Ozonised/Udayate/README.md

# Udayate
An open source flight controller based on STM32F411 microcontroller.
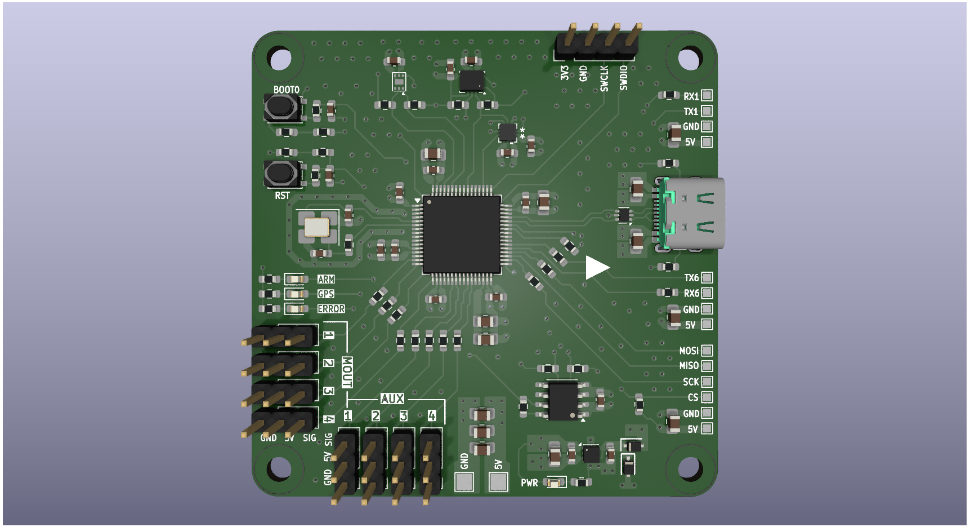
[picture p1: FrontRev2.png]
Front

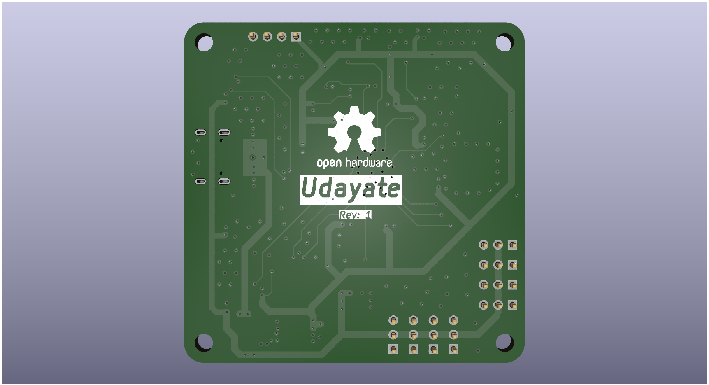
[picture p2: BackRev2.png]
Back
