Ozonised/Udayate/Udayate.kicad_pcb

## KiCad design Udayate.kicad_pcb (2026-01-23)

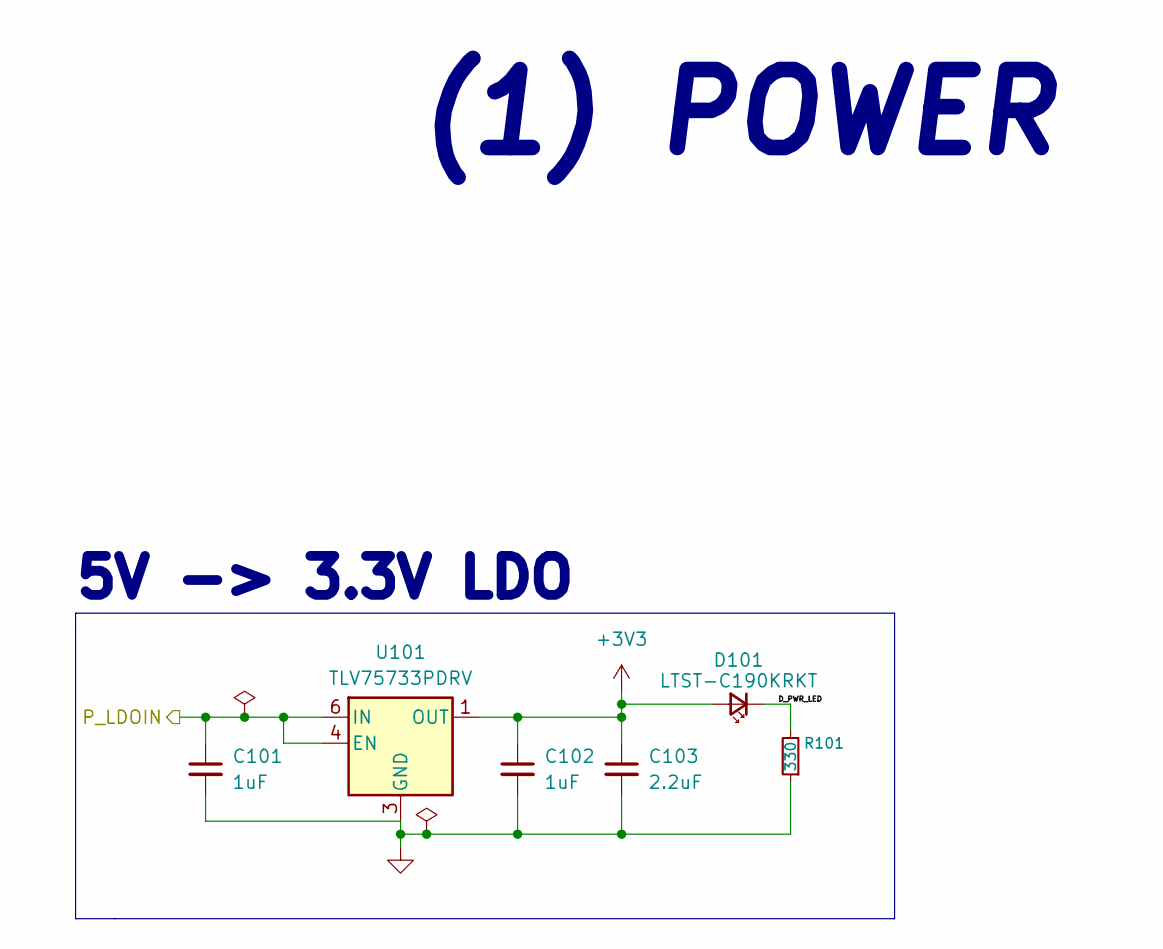
[picture p3: schematic Power.kicad_sch, Udayate]

Parts:
C101, C102: 1uF; C_0603_1608Metric_Pad1.08x0.95mm_HandSolder; MPN C1608X7R1V105K080AC
C103: 2.2uF; C_0805_2012Metric_Pad1.18x1.45mm_HandSolder; MPN GCM21BR71C225MA64L
D101: LTST-C190KRKT; LED_0603_1608Metric_Pad1.05x0.95mm_HandSolder; MPN LTST-C190KRKT
R101: 330; R_0603_1608Metric_Pad0.98x0.95mm_HandSolder; MPN CR0603-FX-3300ELF
U101: TLV75733PDRV; WSON-6-1EP_2x2mm_P0.65mm_EP1x1.6mm; MPN TLV75733PDRV

Connections:
+3V3: C102.1, C103.1, D101.2 (A), U101.1 (OUT); also elsewhere on the board
/IO/P_LDOIN: C101.1, U101.4 (EN), U101.6 (IN); also elsewhere on the board
/Power/D_PWR_LED: D101.1 (K), R101.2
GND: C101.2, C102.2, C103.2, R101.1, U101.3 (GND), U101.7 (GND); also elsewhere on the board

Notes on the sheet:
(1) POWER
5V -> 3.3V LDO

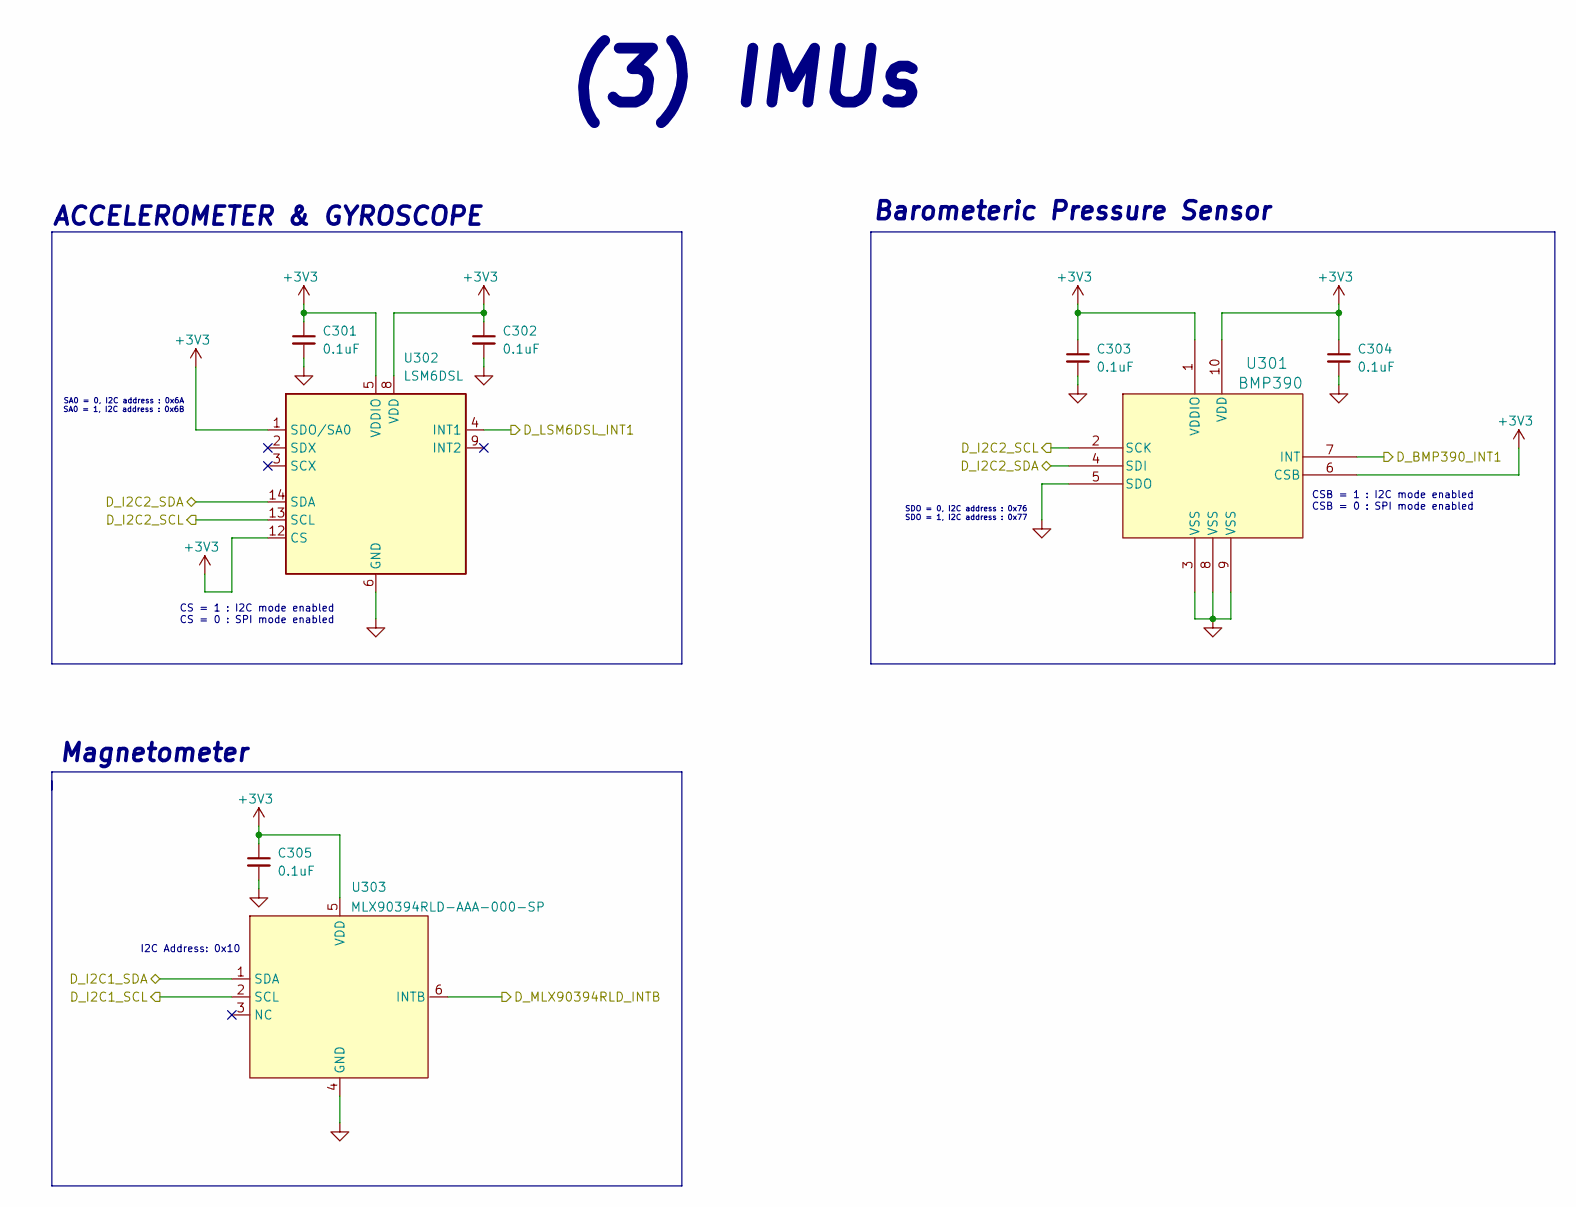
[picture p4: schematic IMUs.kicad_sch, Udayate]

Parts:
C301, C302, C303, C304, C305: 0.1uF; C_0603_1608Metric_Pad1.08x0.95mm_HandSolder; MPN C1608X5R1H104K080AA
U301: BMP390; 10LGA_2X2X0p75_BOS; MPN BMP390
U302: LSM6DSL; LGA-14_3x2.5mm_P0.5mm_LayoutBorder3x4y; MPN LSM6DSL
U303: MLX90394RLD-AAA-000-SP; MLX90394RLD; MPN MLX90394RLD-AAA-000-SP

Connections:
+3V3: C301.1, C302.1, C303.1, C304.1, C305.1, U301.1 (VDDIO), U301.6 (CSB), U301.10 (VDD), U302.1 (SDO/SA0), U302.5 (VDDIO), U302.8 (VDD), U302.12 (CS), U303.5 (VDD); also elsewhere on the board
/IMUs/D_BMP390_INT1: U301.7 (INT); also elsewhere on the board
/IMUs/D_I2C1_SCL: U303.2 (SCL); also elsewhere on the board
/IMUs/D_I2C1_SDA: U303.1 (SDA); also elsewhere on the board
/IMUs/D_I2C2_SCL: U301.2 (SCK), U302.13 (SCL); also elsewhere on the board
/IMUs/D_I2C2_SDA: U301.4 (SDI), U302.14 (SDA); also elsewhere on the board
/IMUs/D_LSM6DSL_INT1: U302.4 (INT1); also elsewhere on the board
/IMUs/D_MLX90394RLD_INTB: U303.6 (INTB); also elsewhere on the board
GND: C301.2, C302.2, C303.2, C304.2, C305.2, U301.3 (VSS), U301.5 (SDO), U301.8 (VSS), U301.9 (VSS), U302.6 (GND), U302.7 (GND), U303.4 (GND); also elsewhere on the board

Notes on the sheet:
CSB = 1 : I2C mode enabled CSB = 0 : SPI mode enabled
(3) IMUs
Magnetometer
SDO = 0, I2C address : 0x76 SDO = 1, I2C address : 0x77
SA0 = 0, I2C address : 0x6A SA0 = 1, I2C address : 0x6B
CS = 1 : I2C mode enabled CS = 0 : SPI mode enabled
I2C Address: 0x10
Barometeric Pressure Sensor
ACCELEROMETER & GYROSCOPE

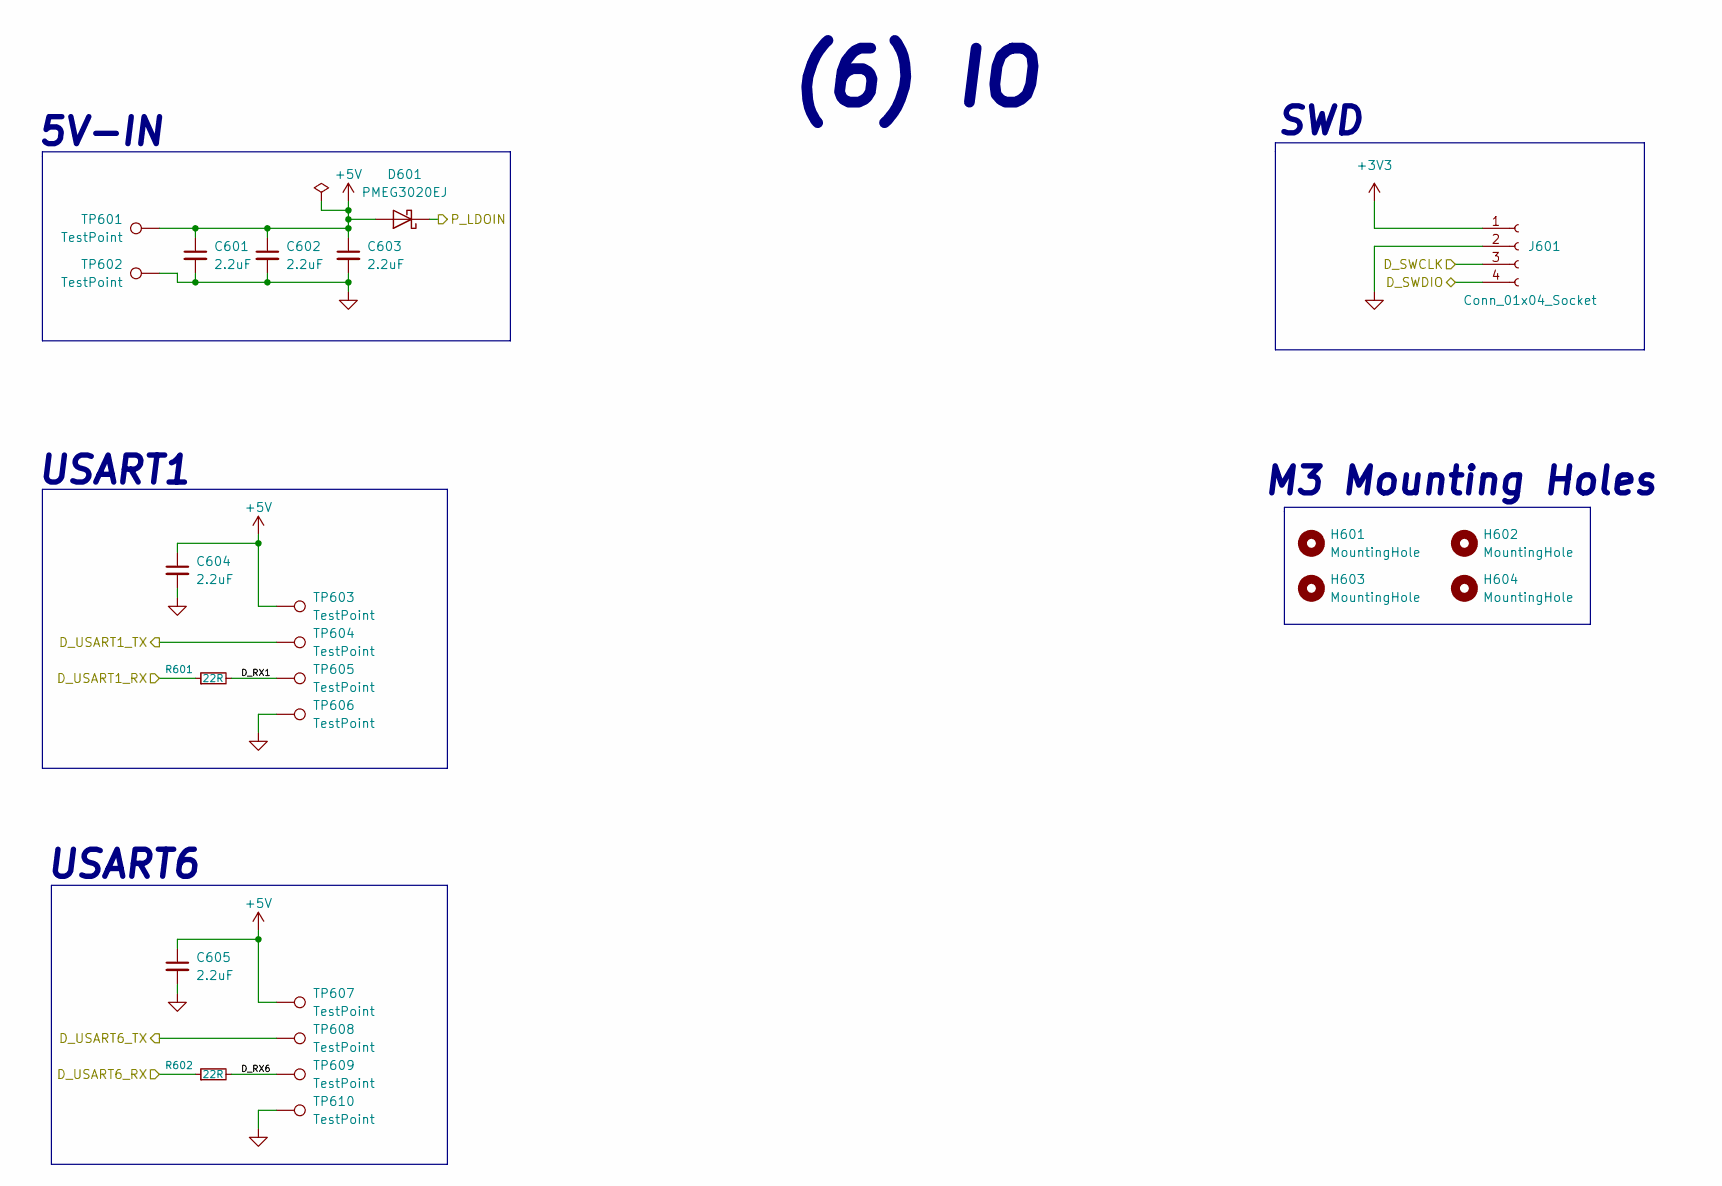
[picture p5: schematic IO2.kicad_sch, Udayate]

Parts:
C601, C602, C603, C604, C605: 2.2uF; C_0805_2012Metric_Pad1.18x1.45mm_HandSolder; MPN GCM21BR71C225MA64L
D601: PMEG3020EJ; D_SOD-323F; MPN PMEG3020EJ,115
H601, H602, H603, H604: MountingHole; MountingHole_3.2mm_M3
J601: Conn_01x04_Socket; PinHeader_1x04_P2.54mm_Vertical
R601, R602: 22R; R_0603_1608Metric_Pad0.98x0.95mm_HandSolder; MPN CR0603-FX-22R0ELF
TP601, TP602: TestPoint; TestPoint_Pad_2.0x2.0mm
TP603, TP604, TP605, TP606, TP607, TP608, TP609, TP610: TestPoint; TestPoint_Pad_1.0x1.0mm

Connections:
+3V3: J601.1; also elsewhere on the board
+5V: C601.1, C602.1, C603.1, C604.1, C605.1, D601.2 (A), TP601.1, TP603.1, TP607.1; also elsewhere on the board
/IO2/D_RX1: R601.2, TP605.1
/IO2/D_RX6: R602.2, TP609.1
/IO2/D_SWCLK: J601.3; also elsewhere on the board
/IO2/D_SWDIO: J601.4; also elsewhere on the board
/IO2/D_USART1_RX: R601.1; also elsewhere on the board
/IO2/D_USART1_TX: TP604.1; also elsewhere on the board
/IO2/D_USART6_RX: R602.1; also elsewhere on the board
/IO2/D_USART6_TX: TP608.1; also elsewhere on the board
/IO/P_LDOIN: D601.1 (K); also elsewhere on the board
GND: C601.2, C602.2, C603.2, C604.2, C605.2, J601.2, TP602.1, TP606.1, TP610.1; also elsewhere on the board

Notes on the sheet:
5V-IN
USART1
(6) IO
SWD
USART6
M3 Mounting Holes

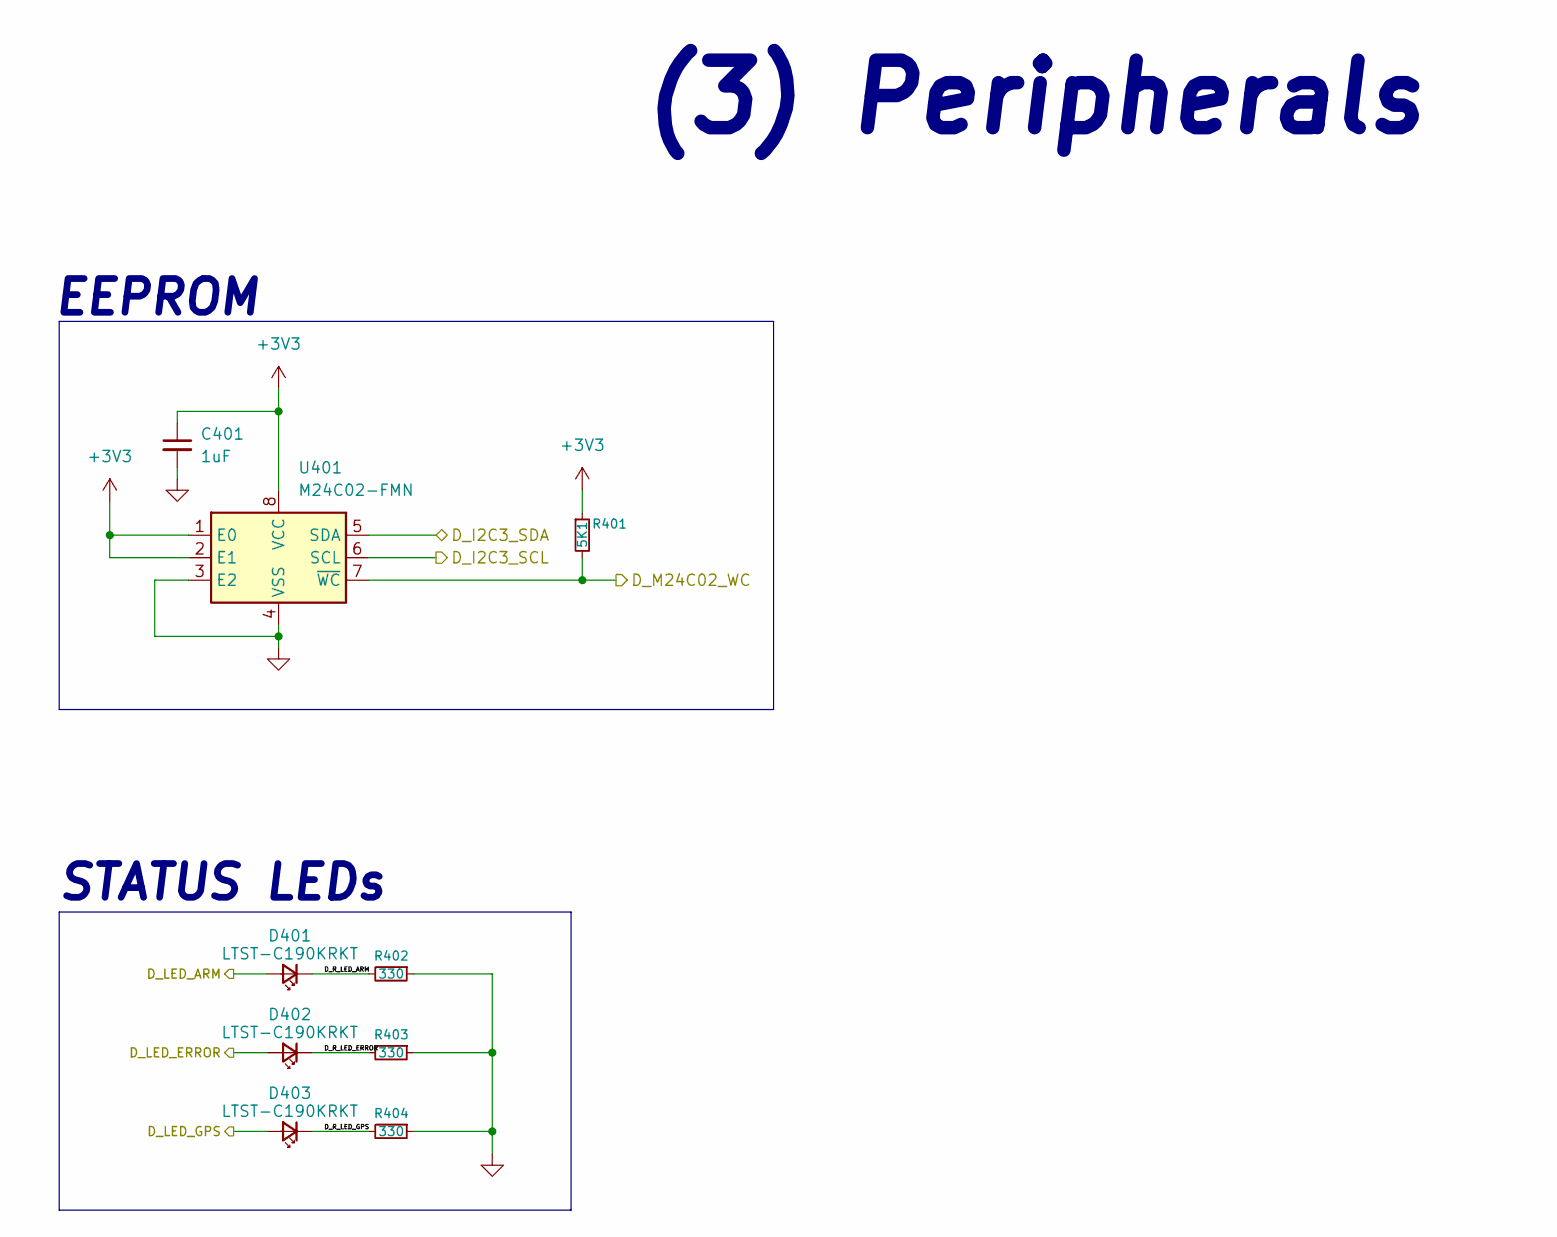
[picture p6: schematic Peripherals.kicad_sch, Udayate]

Parts:
C401: 1uF; C_0603_1608Metric_Pad1.08x0.95mm_HandSolder; MPN C1608X7R1V105K080AC
D401, D402, D403: LTST-C190KRKT; LED_0603_1608Metric_Pad1.05x0.95mm_HandSolder; MPN LTST-C190KRKT
R401: 5K1; R_0603_1608Metric_Pad0.98x0.95mm_HandSolder; MPN CR0603-FX-5101ELF
R402, R403, R404: 330; R_0603_1608Metric_Pad0.98x0.95mm_HandSolder; MPN CR0603-FX-3300ELF
U401: M24C02-FMN; SOIC-8_3.9x4.9mm_P1.27mm; MPN M24C02-FMN6TP

Connections:
+3V3: C401.1, R401.1, U401.1 (E0), U401.2 (E1), U401.8 (VCC); also elsewhere on the board
/MCU/D_I2C3_SCL: U401.6 (SCL); also elsewhere on the board
/MCU/D_I2C3_SDA: U401.5 (SDA); also elsewhere on the board
/MCU/D_LED_ARM: D401.2 (A); also elsewhere on the board
/MCU/D_LED_ERROR: D402.2 (A); also elsewhere on the board
/MCU/D_LED_GPS: D403.2 (A); also elsewhere on the board
/MCU/D_M24C02_WC: R401.2, U401.7 (~WC); also elsewhere on the board
/Peripherals/D_R_LED_ARM: D401.1 (K), R402.2
/Peripherals/D_R_LED_ERROR: D402.1 (K), R403.2
/Peripherals/D_R_LED_GPS: D403.1 (K), R404.2
GND: C401.2, R402.1, R403.1, R404.1, U401.3 (E2), U401.4 (VSS); also elsewhere on the board

Notes on the sheet:
(3) Peripherals
STATUS LEDs
EEPROM

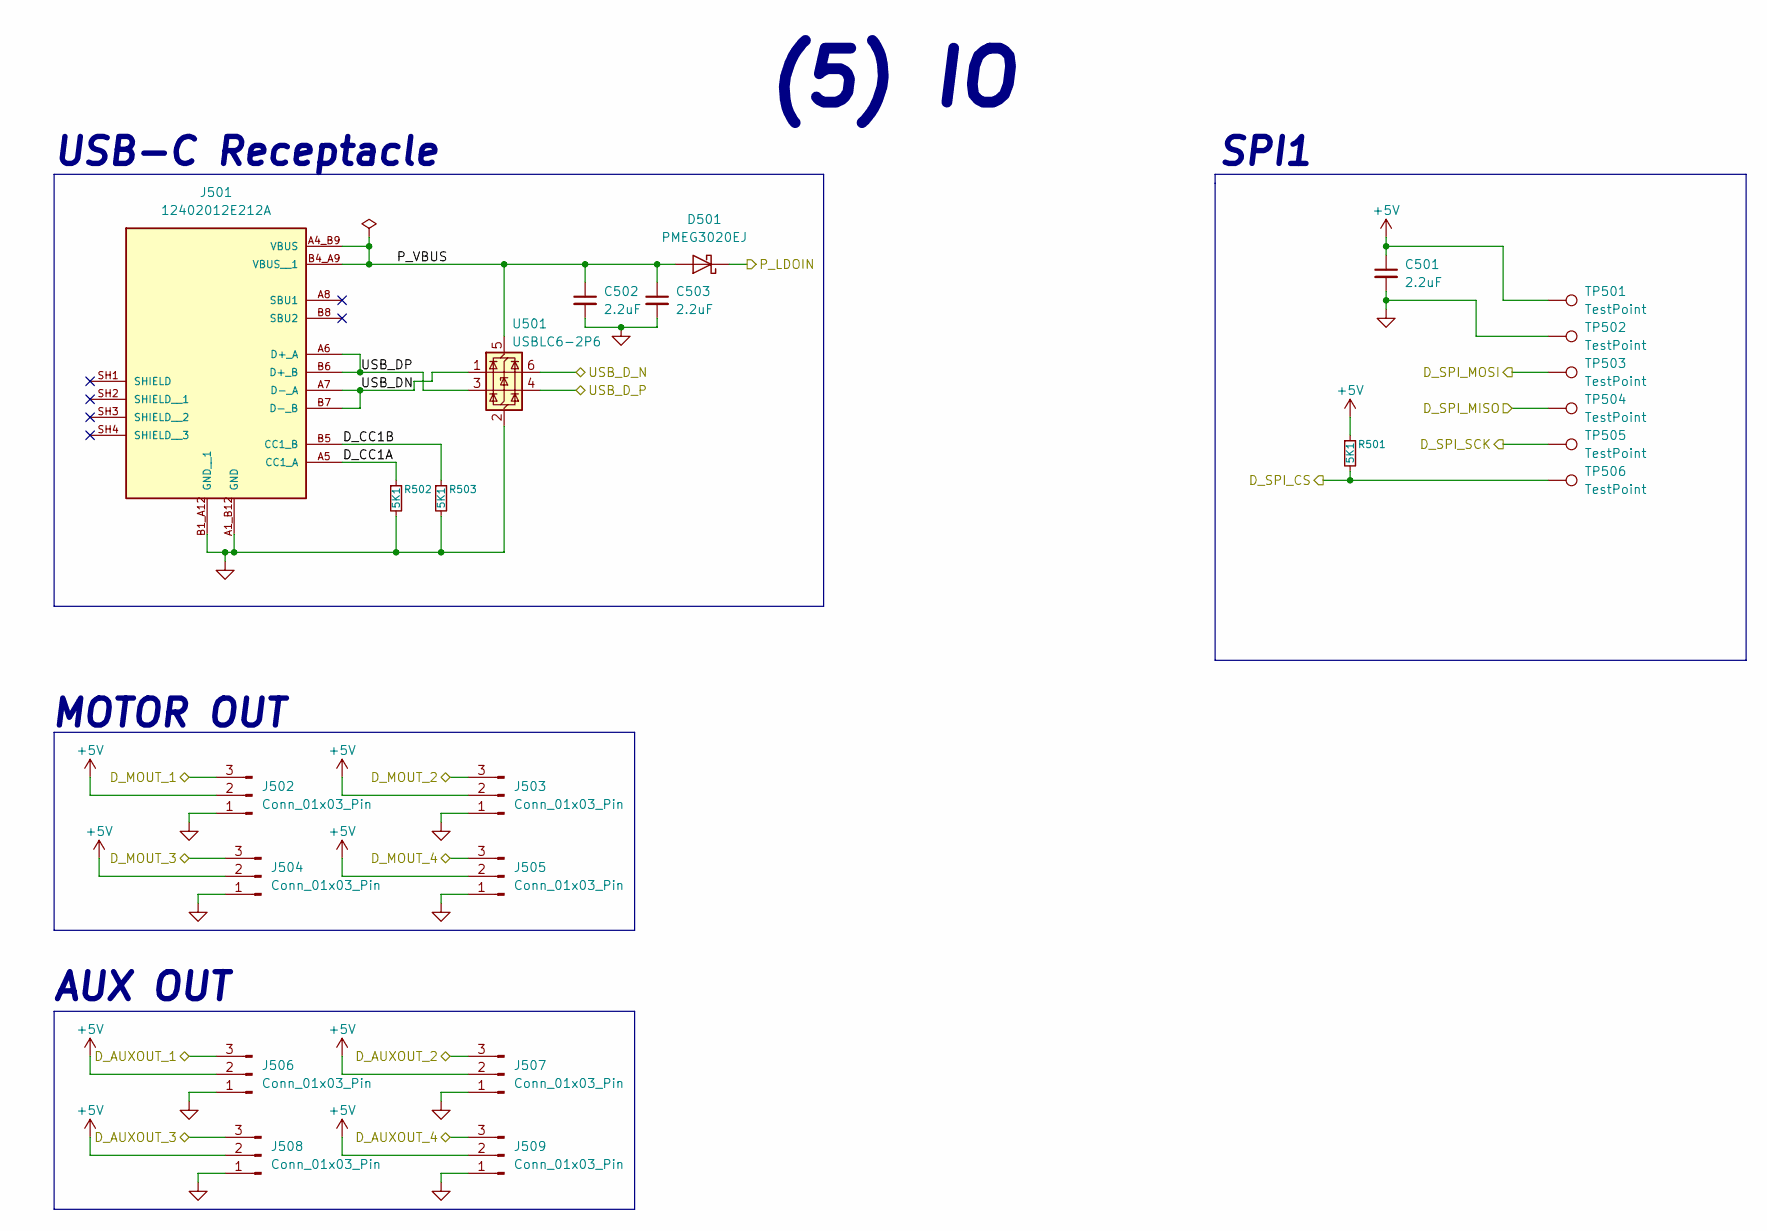
[picture p7: schematic IO.kicad_sch, Udayate]

Parts:
C501, C502, C503: 2.2uF; C_0805_2012Metric_Pad1.18x1.45mm_HandSolder; MPN GCM21BR71C225MA64L
D501: PMEG3020EJ; D_SOD-323F; MPN PMEG3020EJ,115
J501: 12402012E212A; AMPHENOL_12402012E212A; PARTREV 4
J502, J503, J504, J505, J506, J507, J508, J509: Conn_01x03_Pin; PinHeader_1x03_P2.54mm_Vertical
R501, R502, R503: 5K1; R_0603_1608Metric_Pad0.98x0.95mm_HandSolder; MPN CR0603-FX-5101ELF
TP501, TP502, TP503, TP504, TP505, TP506: TestPoint; TestPoint_Pad_1.0x1.0mm
U501: USBLC6-2P6; SOT-666

Connections:
+5V: C501.1, J502.2, J503.2, J504.2, J505.2, J506.2, J507.2, J508.2, J509.2, R501.1, TP501.1; also elsewhere on the board
/IO/D_AUXOUT_1: J506.3; also elsewhere on the board
/IO/D_AUXOUT_2: J507.3; also elsewhere on the board
/IO/D_AUXOUT_3: J508.3; also elsewhere on the board
/IO/D_AUXOUT_4: J509.3; also elsewhere on the board
/IO/D_CC1A: J501.A5 (CC1_A), R502.1
/IO/D_CC1B: J501.B5 (CC1_B), R503.1
/IO/D_MOUT_1: J502.3; also elsewhere on the board
/IO/D_MOUT_2: J503.3; also elsewhere on the board
/IO/D_MOUT_3: J504.3; also elsewhere on the board
/IO/D_MOUT_4: J505.3; also elsewhere on the board
/IO/D_SPI_CS: R501.2, TP506.1; also elsewhere on the board
/IO/D_SPI_MISO: TP504.1; also elsewhere on the board
/IO/D_SPI_MOSI: TP503.1; also elsewhere on the board
/IO/D_SPI_SCK: TP505.1; also elsewhere on the board
/IO/P_LDOIN: D501.1 (K); also elsewhere on the board
/IO/P_VBUS: C502.1, C503.1, D501.2 (A), J501.A4_B9 (VBUS), J501.B4_A9 (VBUS__1), U501.5 (VBUS)
/IO/USB_DN: J501.A7 (D-_A), J501.B7 (D-_B), U501.1 (I/O1)
/IO/USB_DP: J501.A6 (D+_A), J501.B6 (D+_B), U501.3 (I/O2)
/IO/USB_D_N: U501.6 (I/O1); also elsewhere on the board
/IO/USB_D_P: U501.4 (I/O2); also elsewhere on the board
GND: C501.2, C502.2, C503.2, J501.A1_B12 (GND), J501.B1_A12 (GND__1), J502.1, J503.1, J504.1, J505.1, J506.1, J507.1, J508.1, J509.1, R502.2, R503.2, TP502.1, U501.2 (GND); also elsewhere on the board

Notes on the sheet:
MOTOR OUT
SPI1
USB-C Receptacle
(5) IO
AUX OUT

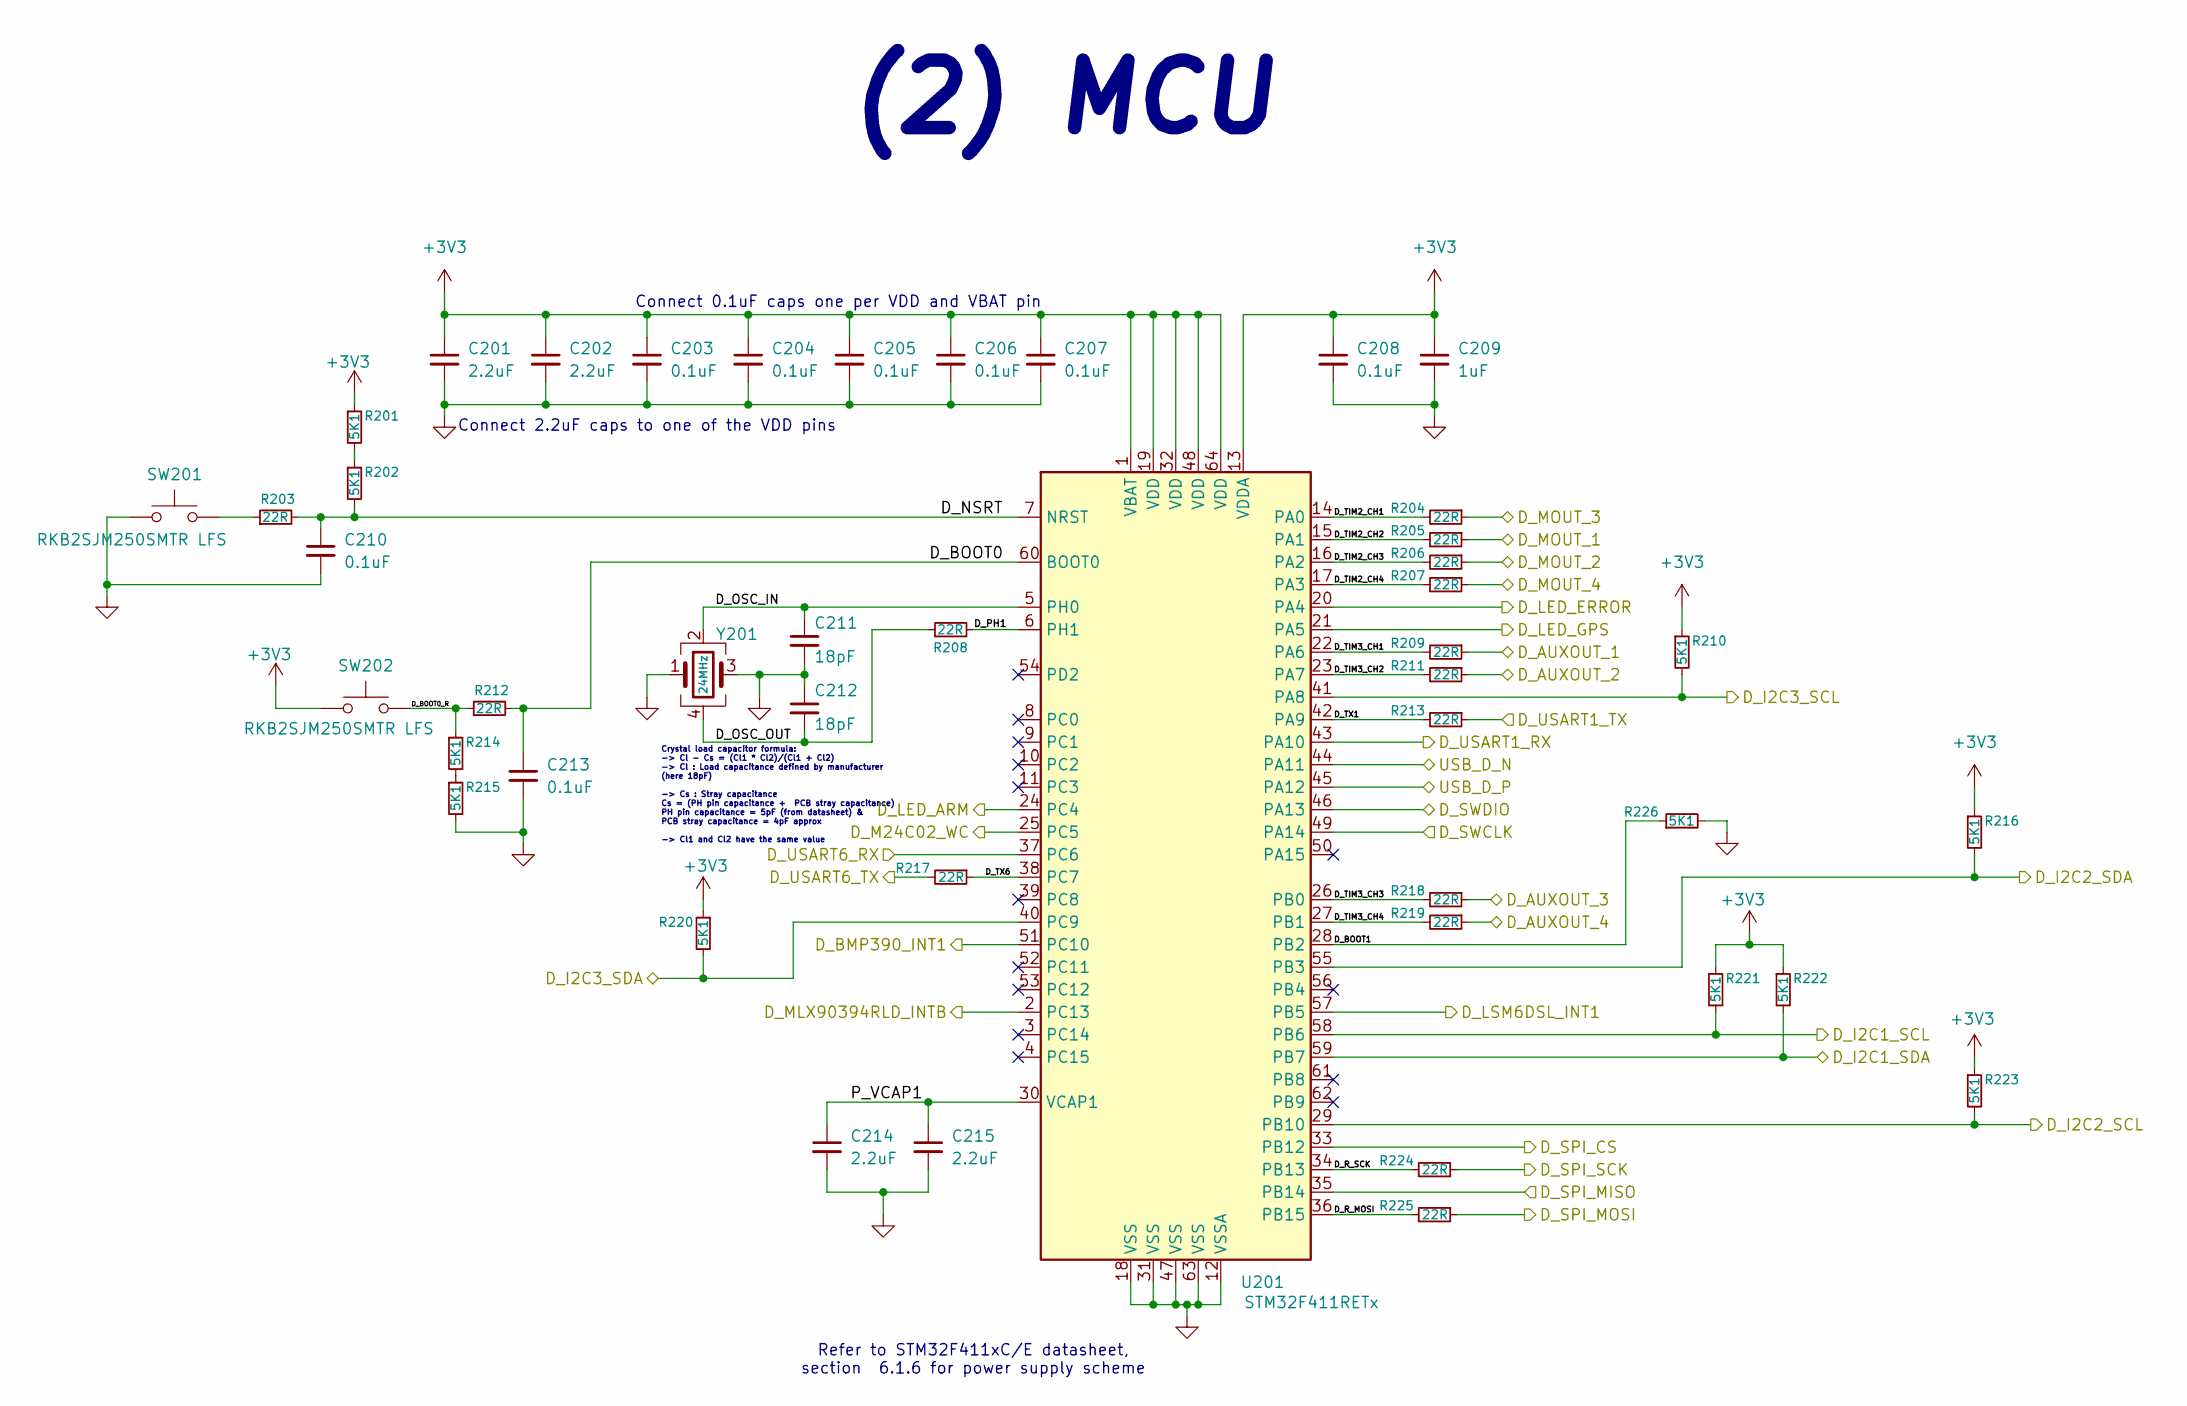
[picture p8: schematic MCU.kicad_sch, Udayate]

Parts:
C201, C202, C214, C215: 2.2uF; C_0805_2012Metric_Pad1.18x1.45mm_HandSolder; MPN GCM21BR71C225MA64L
C203, C204, C205, C206, C207, C208, C210, C213: 0.1uF; C_0603_1608Metric_Pad1.08x0.95mm_HandSolder; MPN C1608X5R1H104K080AA
C209: 1uF; C_0603_1608Metric_Pad1.08x0.95mm_HandSolder; MPN C1608X7R1V105K080AC
C211, C212: 18pF; C_0603_1608Metric_Pad1.08x0.95mm_HandSolder; MPN 06035A180JAT4A
R201, R202, R210, R214, R215, R216, R220, R221, R222, R223, R226: 5K1; R_0603_1608Metric_Pad0.98x0.95mm_HandSolder; MPN CR0603-FX-5101ELF
R203, R204, R205, R206, R207, R208, R209, R211, R212, R213, R217, R218, R219, R224, R225: 22R; R_0603_1608Metric_Pad0.98x0.95mm_HandSolder; MPN CR0603-FX-22R0ELF
SW201, SW202: RKB2SJM250SMTR LFS; SW_SPST_PTS810; MPN RKB2SJM250SMTR LFS
U201: STM32F411RETx; LQFP-64_10x10mm_P0.5mm; MPN STM32F411RET6
Y201: 24MHz; Crystal_SMD_3225-4Pin_3.2x2.5mm_HandSoldering; MPN ABM8-24.000MHZ-D4Y-T

Connections:
+3V3: C201.1, C202.1, C203.1, C204.1, C205.1, C206.1, C207.1, C208.1, C209.1, R201.1, R210.1, R216.1, R220.1, R221.1, R222.1, R223.1, SW202.1, U201.1 (VBAT), U201.13 (VDDA), U201.19 (VDD), U201.32 (VDD), U201.48 (VDD), U201.64 (VDD); also elsewhere on the board
/IMUs/D_BMP390_INT1: U201.51 (PC10); also elsewhere on the board
/IMUs/D_I2C1_SCL: R221.2, U201.58 (PB6); also elsewhere on the board
/IMUs/D_I2C1_SDA: R222.2, U201.59 (PB7); also elsewhere on the board
/IMUs/D_I2C2_SCL: R223.2, U201.29 (PB10); also elsewhere on the board
/IMUs/D_I2C2_SDA: R216.2, U201.55 (PB3); also elsewhere on the board
/IMUs/D_LSM6DSL_INT1: U201.57 (PB5); also elsewhere on the board
/IMUs/D_MLX90394RLD_INTB: U201.2 (PC13); also elsewhere on the board
/IO2/D_SWCLK: U201.49 (PA14); also elsewhere on the board
/IO2/D_SWDIO: U201.46 (PA13); also elsewhere on the board
/IO2/D_USART1_RX: U201.43 (PA10); also elsewhere on the board
/IO2/D_USART1_TX: R213.1; also elsewhere on the board
/IO2/D_USART6_RX: U201.37 (PC6); also elsewhere on the board
/IO2/D_USART6_TX: R217.2; also elsewhere on the board
/IO/D_AUXOUT_1: R209.1; also elsewhere on the board
/IO/D_AUXOUT_2: R211.1; also elsewhere on the board
/IO/D_AUXOUT_3: R218.1; also elsewhere on the board
/IO/D_AUXOUT_4: R219.1; also elsewhere on the board
/IO/D_MOUT_1: R205.1; also elsewhere on the board
/IO/D_MOUT_2: R206.1; also elsewhere on the board
/IO/D_MOUT_3: R204.1; also elsewhere on the board
/IO/D_MOUT_4: R207.1; also elsewhere on the board
/IO/D_SPI_CS: U201.33 (PB12); also elsewhere on the board
/IO/D_SPI_MISO: U201.35 (PB14); also elsewhere on the board
/IO/D_SPI_MOSI: R225.1; also elsewhere on the board
/IO/D_SPI_SCK: R224.1; also elsewhere on the board
/IO/USB_D_N: U201.44 (PA11); also elsewhere on the board
/IO/USB_D_P: U201.45 (PA12); also elsewhere on the board
/MCU/D_BOOT0: C213.1, R212.2, U201.60 (BOOT0)
/MCU/D_BOOT0_R: R212.1, R214.1, SW202.2
/MCU/D_BOOT1: R226.1, U201.28 (PB2)
/MCU/D_I2C3_SCL: R210.2, U201.41 (PA8); also elsewhere on the board
/MCU/D_I2C3_SDA: R220.2, U201.40 (PC9); also elsewhere on the board
/MCU/D_LED_ARM: U201.24 (PC4); also elsewhere on the board
/MCU/D_LED_ERROR: U201.20 (PA4); also elsewhere on the board
/MCU/D_LED_GPS: U201.21 (PA5); also elsewhere on the board
/MCU/D_M24C02_WC: U201.25 (PC5); also elsewhere on the board
/MCU/D_NSRT: C210.1, R202.2, R203.2, U201.7 (NRST)
/MCU/D_OSC_IN: C211.1, U201.5 (PH0), Y201.2
/MCU/D_OSC_OUT: C212.2, R208.1, Y201.4
/MCU/D_PH1: R208.2, U201.6 (PH1)
/MCU/D_R_MOSI: R225.2, U201.36 (PB15)
/MCU/D_R_SCK: R224.2, U201.34 (PB13)
/MCU/D_TIM2_CH1: R204.2, U201.14 (PA0)
/MCU/D_TIM2_CH2: R205.2, U201.15 (PA1)
/MCU/D_TIM2_CH3: R206.2, U201.16 (PA2)
/MCU/D_TIM2_CH4: R207.2, U201.17 (PA3)
/MCU/D_TIM3_CH1: R209.2, U201.22 (PA6)
/MCU/D_TIM3_CH2: R211.2, U201.23 (PA7)
/MCU/D_TIM3_CH3: R218.2, U201.26 (PB0)
/MCU/D_TIM3_CH4: R219.2, U201.27 (PB1)
/MCU/D_TX1: R213.2, U201.42 (PA9)
/MCU/D_TX6: R217.1, U201.38 (PC7)
/MCU/P_VCAP1: C214.1, C215.1, U201.30 (VCAP1)
GND: C201.2, C202.2, C203.2, C204.2, C205.2, C206.2, C207.2, C208.2, C209.2, C210.2, C211.2, C212.1, C213.2, C214.2, C215.2, R215.2, R226.2, SW201.1, U201.12 (VSSA), U201.18 (VSS), U201.31 (VSS), U201.47 (VSS), U201.63 (VSS), Y201.1, Y201.3; also elsewhere on the board
unnamed: R201.2, R202.1
unnamed: R203.1, SW201.2
unnamed: R214.2, R215.1

Notes on the sheet:
Connect 0.1uF caps one per VDD and VBAT pin
Refer to STM32F411xC/E datasheet, section 6.1.6 for power supply scheme
Connect 2.2uF caps to one of the VDD pins
(2) MCU
Crystal load capacitor formula: -> Cl - Cs = (Cl1 * Cl2)/(Cl1 + Cl2) -> Cl : Load capacitance defined by manufacturer (here 18pF) -> Cs : Stray capacitance Cs = (PH pin capacitance + PCB stray capacitance) PH pin capacitance = 5pF (from datasheet) & PCB stray capacitance = 4pF approx -> Cl1 and Cl2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

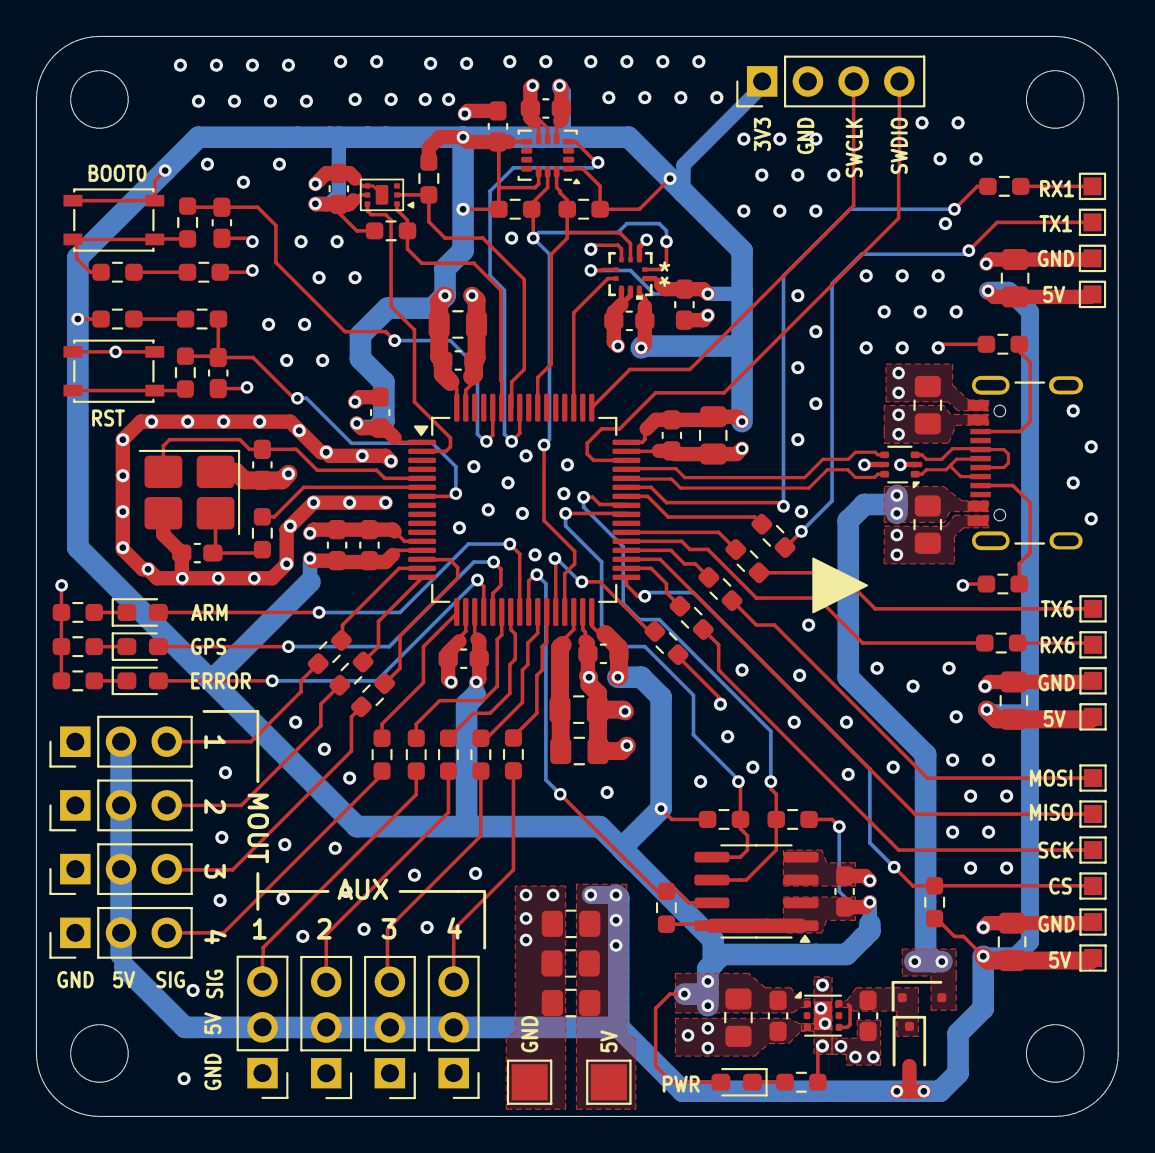
[picture p9: board Udayate.kicad_pcb from above]

Board: 4 copper layers, 60.1 x 60.0 mm, 114 parts (0 on the bottom side), 71 nets.
