Ozonised/Udayate/(commit log)

2025-09-12 feat: add Udayate V1
    [IMUs.kicad_sch, IO.kicad_sch, IO2.kicad_sch, MCU.kicad_sch, Peripherals.kicad_sch, Power.kicad_sch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]
2025-09-12 docs: add CERN-OHL-S-2.0 license
    [IMUs.kicad_sch, IO.kicad_sch, IO2.kicad_sch, MCU.kicad_sch, Peripherals.kicad_sch, Power.kicad_sch, Udayate.kicad_pcb, Udayate.kicad_sch]
2025-09-12 docs: add board pics
2025-09-12 docs: add github repo link
    [IMUs.kicad_sch, IO.kicad_sch, IO2.kicad_sch, MCU.kicad_sch, Peripherals.kicad_sch, Power.kicad_sch, Udayate.kicad_pcb, Udayate.kicad_sch]
2025-09-13 fix: repositioned R24 - R206 & add silk screen for 5V input
    [MCU.kicad_sch, Udayate.kicad_pcb]
2025-09-13 fix: update gerbers to match new fixes
    [Udayate-B_Cu.gbl, Udayate-B_Mask.gbs, Udayate-B_Paste.gbp, Udayate-B_Silkscreen.gbo, Udayate-Edge_Cuts.gm1, Udayate-F_Cu.gtl, Udayate-F_Mask.gts, Udayate-F_Paste.gtp]
2025-09-13 docs: add pcb front image
2025-10-04 fix: fix magnetometer pinout
    [IMUs.kicad_sch, IO.kicad_sch, IO2.kicad_sch, MCU.kicad_sch, Peripherals.kicad_sch, Power.kicad_sch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]
2025-10-04 fix: update rev version silkscreen on PCB
    [Udayate-B_Cu.gbl, Udayate-B_Mask.gbs, Udayate-B_Paste.gbp, Udayate-B_Silkscreen.gbo, Udayate-Edge_Cuts.gm1, Udayate-F_Cu.gtl, Udayate-F_Mask.gts, Udayate-F_Paste.gtp]
2025-10-04 fix: pin 1 marker for magnetometer
    [Udayate-B_Cu.gbl, Udayate-B_Mask.gbs, Udayate-B_Paste.gbp, Udayate-B_Silkscreen.gbo, Udayate-Edge_Cuts.gm1, Udayate-F_Cu.gtl, Udayate-F_Mask.gts, Udayate-F_Paste.gtp]
2025-10-06 docs: add ibom for assembly
2026-01-06 fix: EEPROM WC assigned to PC25
    boot1 pull down, DFU now works
    [MCU.kicad_sch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]
2026-01-06 docs: change rev version to 1.2
    [IMUs.kicad_sch, IO.kicad_sch, IO2.kicad_sch, MCU.kicad_sch, Peripherals.kicad_sch, Power.kicad_sch, Udayate.kicad_pcb, Udayate.kicad_sch]
2026-01-09 fix: barometer I2C address
    [IMUs.kicad_sch]
2026-01-23 fix:mag & imu axis align
    - change mag layout
    - generate new bom
    - changed rev num
    [IMUs.kicad_sch, IO.kicad_sch, IO2.kicad_sch, MCU.kicad_sch, Peripherals.kicad_sch, Power.kicad_sch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]
