Ozonised/Udayate/(notices)

Notices in the files:
IMUs.kicad_sch:
LICENSE: CERN-OHL-S-2.0
